costarc/MSXPi/hardware/Schematic/MSXPi_v0.7.0_Rev_1/msxpi.brd

## EAGLE design hardware/Schematic/MSXPi_v0.7.0_Rev_1/msxpi.brd (2017-06-21)

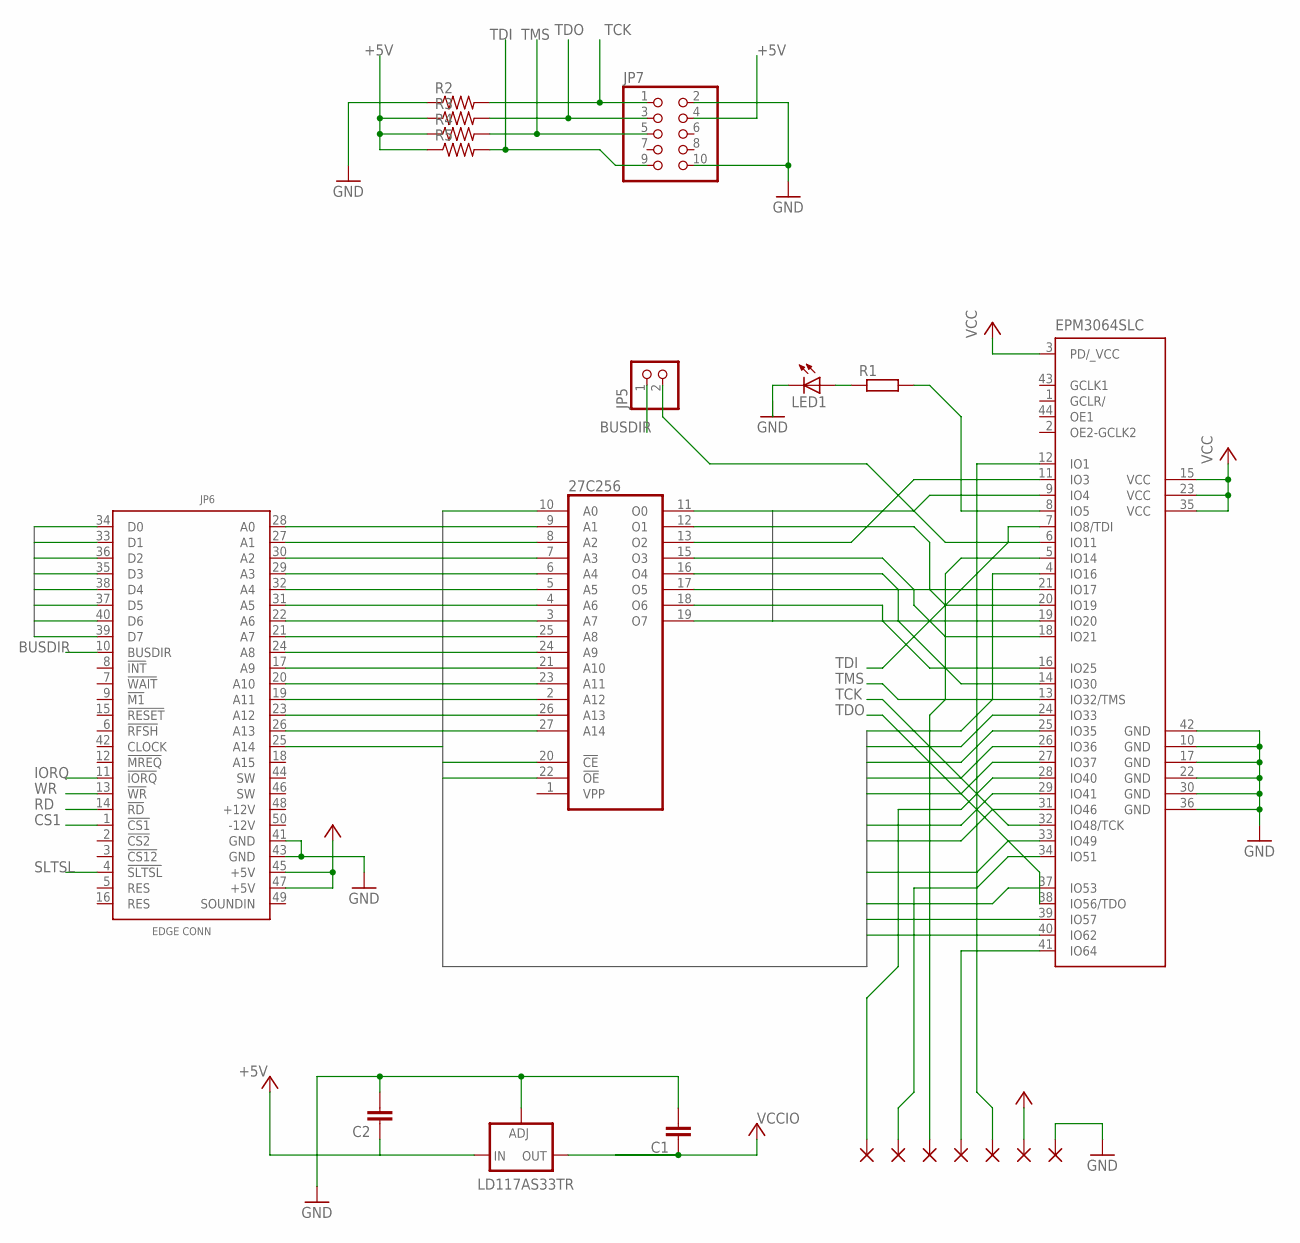
[picture p1: schematic msxpi.sch]

Parts:
27C256: 27256; DIL28
+5V: 2,15/1,0
C1, C2: C2,5-3; C2.5-3
EPM3064SLC: EPM3064S44; PLCC-S44
GND: 2,15/1,0
IC1: LD117AS33TR; SOT223
JP5: PINHD-1X2; 1X02
JP6: MSXCART1; MSXCART
JP7: PINHD-2X5/90; 2X05/90
LED1: LED3MM
PAD1, PAD2, PAD8, PAD9: 2,15/1,0
R1: R-EU_0207/7; 0207/7
R2, R3, R4, R5: R-US_0207/7; 0207/7
SPI_CS_GPIO21: 2,15/1,0

Connections:
+5V: 27C256.28 (VCC), +5V.1, C2.1, IC1.3 (IN), JP6.45 (+5V), JP6.47 (+5V), JP7.4, R3.1, R4.1, R5.1
A0: 27C256.10 (A0), EPM3064SLC.31 (IO46), JP6.28 (A0)
A1: 27C256.9 (A1), EPM3064SLC.29 (IO41), JP6.27 (A1)
A2: 27C256.8 (A2), EPM3064SLC.24 (IO33), JP6.30 (A2)
A3: 27C256.7 (A3), EPM3064SLC.26 (IO36), JP6.29 (A3)
A4: 27C256.6 (A4), EPM3064SLC.25 (IO35), JP6.32 (A4)
A5: 27C256.5 (A5), EPM3064SLC.27 (IO37), JP6.31 (A5)
A6: 27C256.4 (A6), EPM3064SLC.33 (IO49), JP6.22 (A6)
A7: 27C256.3 (A7), EPM3064SLC.4 (IO16), JP6.21 (A7)
A8: 27C256.25 (A8), JP6.24 (A8)
A9: 27C256.24 (A9), JP6.17 (A9)
A10: 27C256.21 (A10), JP6.20 (A10)
A11: 27C256.23 (A11), JP6.19 (A11)
A12: 27C256.2 (A12), JP6.23 (A12)
A13: 27C256.26 (A13), JP6.26 (A13)
A14: 27C256.27 (A14), JP6.25 (A14)
BUSDIR: JP5.1, JP6.10 (BUSDIR)
CS1: 27C256.22 (!OE), JP6.1 (!CS1)
D0: 27C256.11 (O0), EPM3064SLC.9 (IO4), JP6.34 (D0)
D1: 27C256.12 (O1), EPM3064SLC.20 (IO19), JP6.33 (D1)
D2: 27C256.13 (O2), EPM3064SLC.11 (IO3), JP6.36 (D2)
D3: 27C256.15 (O3), EPM3064SLC.18 (IO21), JP6.35 (D3)
D4: 27C256.16 (O4), EPM3064SLC.14 (IO30), JP6.38 (D4)
D5: 27C256.17 (O5), EPM3064SLC.21 (IO17), JP6.37 (D5)
D6: 27C256.18 (O6), EPM3064SLC.16 (IO25), JP6.40 (D6)
D7: 27C256.19 (O7), EPM3064SLC.19 (IO20), JP6.39 (D7)
GND: 27C256.14 (GND), C1.2, C2.2, EPM3064SLC.10 (GND), EPM3064SLC.17 (GND), EPM3064SLC.22 (GND), EPM3064SLC.30 (GND), EPM3064SLC.36 (GND), EPM3064SLC.42 (GND), GND.1, IC1.1 (ADJ), JP6.41 (GND), JP6.43 (GND), JP7.2, JP7.10, LED1.K (C), R2.1
IORQ: EPM3064SLC.40 (IO62), JP6.11 (!IORQ)
MSXR1: EPM3064SLC.6 (IO11), JP5.2
unnamed: LED1.A, R1.1
unnamed: EPM3064SLC.8 (IO5), R1.2
PI_RDY_GPIO25: EPM3064SLC.12 (IO1), PAD2.1
RD: EPM3064SLC.37 (IO53), JP6.14 (!RD)
SLTSL: 27C256.20 (!CE), JP6.4 (!SLTSL)
SPI_CS_GPIO21: EPM3064SLC.28 (IO40), SPI_CS_GPIO21.1
SPI_MISO_GPIO12: EPM3064SLC.41 (IO64), PAD1.1
SPI_MOSI_GPIO16: EPM3064SLC.5 (IO14), PAD9.1
SPI_SCLK_GPIO20: EPM3064SLC.34 (IO51), PAD8.1
TCK: EPM3064SLC.32 (IO48/TCK), JP7.1, R2.2
TDI: EPM3064SLC.7 (IO8/TDI), JP7.9, R5.2
TDO: EPM3064SLC.38 (IO56/TDO), JP7.3, R3.2
TMS: EPM3064SLC.13 (IO32/TMS), JP7.5, R4.2
VCCIO: C1.1, EPM3064SLC.3 (PD/_VCC), EPM3064SLC.15 (VCC), EPM3064SLC.23 (VCC), EPM3064SLC.35 (VCC), IC1.4 (OUT)
WR: EPM3064SLC.39 (IO57), JP6.13 (!WR)

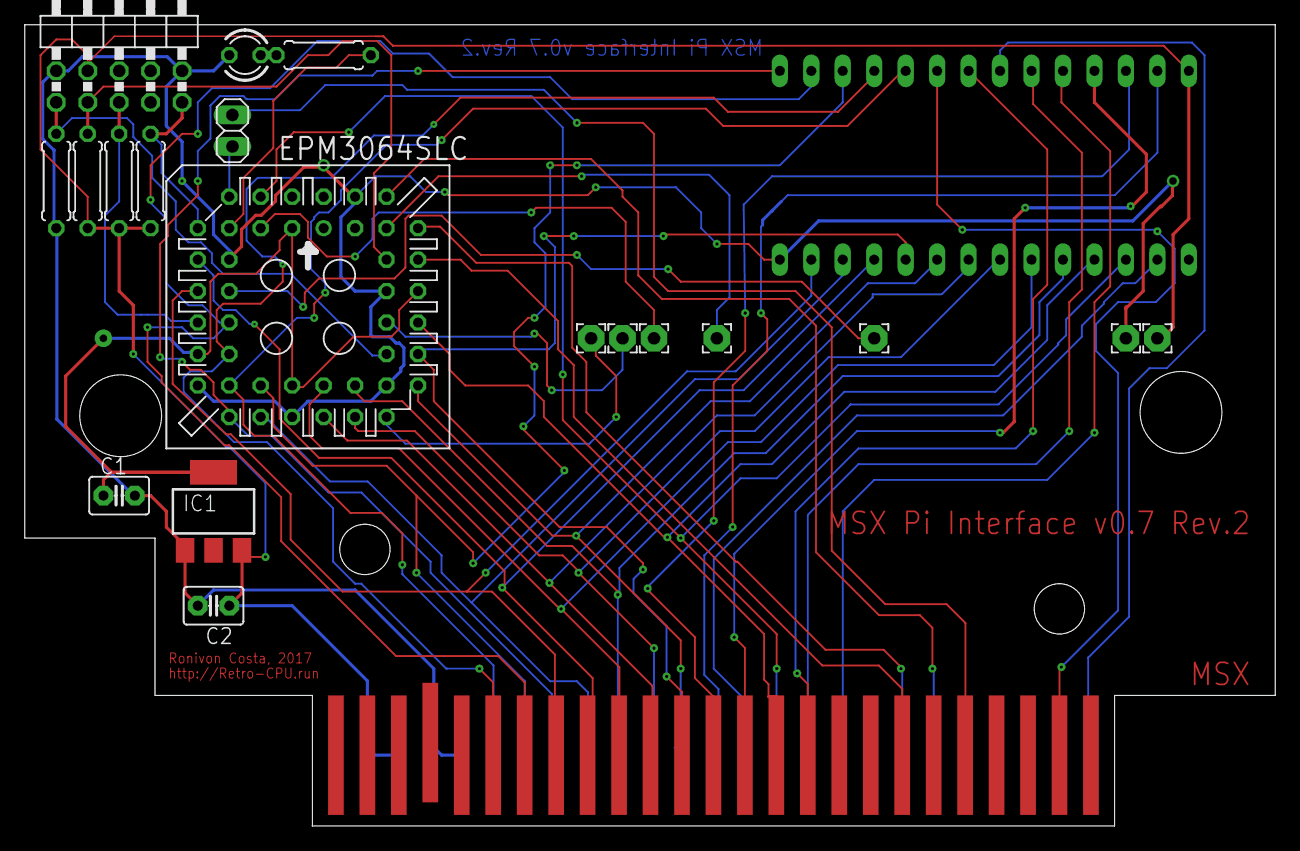
[picture p2: board msxpi.brd from above]

Board: 2 copper layers, 101.0 x 64.7 mm, 21 parts (1 on the bottom side), 44 nets.
