costarc/MSXPi/hardware/Schematic/MSXPi_v1.0_Rev1/MSXPi1.kicad_pcb

## KiCad design hardware/Schematic/MSXPi_v1.0_Rev1/MSXPi1.kicad_pcb (2020-08-07)

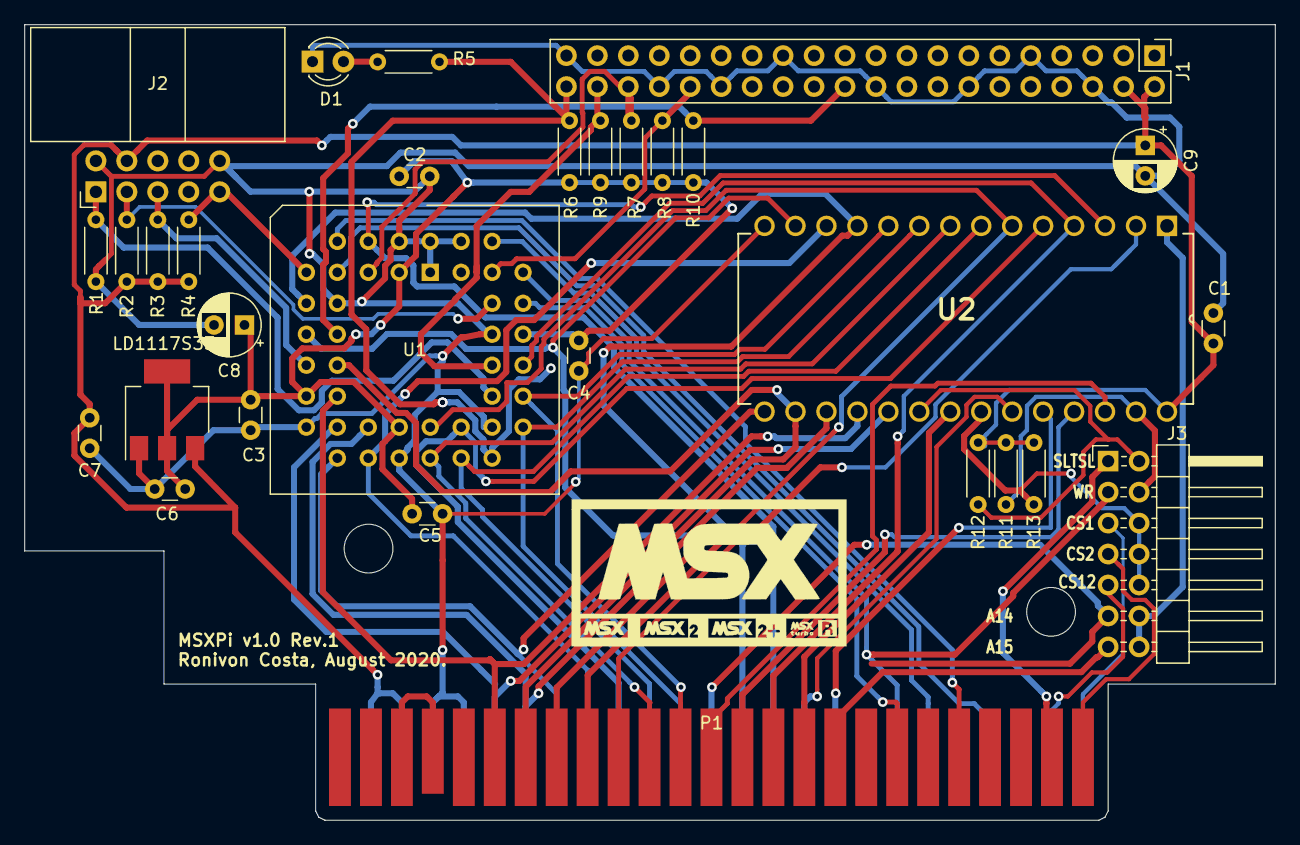
[picture p3: board MSXPi1.kicad_pcb from above]

Board: 2 copper layers, 102.6 x 65.3 mm, 30 parts (0 on the bottom side), 51 nets.

Parts:
C1, C2, C3, C4, C5, C6, C7: 100nF; C_Disc_D3.0mm_W1.6mm_P2.50mm
C8, C9: 100uF; CP_Radial_D5.0mm_P2.50mm
D1: LED; LED_D3.0mm
J1: Raspberry_Pi_Zero_2_3; PinHeader_2x20_P2.54mm_Vertical
J2: JTAG; IDC-Header_2x05_P2.54mm_Horizontal
J3: Conn_02x07_Odd_Even; PinHeader_2x07_P2.54mm_Horizontal
LD1117S33: LD1117S33TR_SOT223; SOT-223-3_TabPin2
P1: MSX_CONNECTOR; card_edge_connector
R1, R2, R3, R4: 1k; R_Axial_DIN0204_L3.6mm_D1.6mm_P5.08mm_Horizontal
R5: 270R; R_Axial_DIN0204_L3.6mm_D1.6mm_P5.08mm_Horizontal
R6, R7: 10K; R_Axial_DIN0204_L3.6mm_D1.6mm_P5.08mm_Horizontal
R8, R9, R10, R11, R12, R13: 10k; R_Axial_DIN0204_L3.6mm_D1.6mm_P5.08mm_Horizontal
U1: EPM3064ALC44-10; PLCC-44_THT-Socket
U2: AT28C256-15PU; DIP254P1524X482-28

Connections:
+3V3: C2.2, C3.2, C4.2, C5.2, C6.2, C8.1, LD1117S33.2, R6.2, R7.2, R8.2, R9.2, R10.2, U1.3, U1.15, U1.23, U1.35
+5V: C1.1, C7.2, C9.1, J1.2, J1.4, J2.4, LD1117S33.3, P1.45, P1.47, R2.2, R3.2, R4.2, R11.2, R12.2, R13.2, U2.28
A0: P1.28, U1.31, U2.10
A1: P1.27, U1.29, U2.9
A2: P1.30, U1.24, U2.8
A3: P1.29, U1.26, U2.7
A4: P1.32, U1.25, U2.6
A5: P1.31, U1.27, U2.5
A6: P1.22, U1.33, U2.4
A7: P1.21, U1.4, U2.3
A8: P1.24, U2.25
A9: P1.17, U2.24
A10: P1.20, U2.21
A11: P1.19, U2.23
A12: P1.23, U2.2
A13: P1.26, U2.26
A14: J3.11, P1.25
A15: J3.13, P1.18
BUSDIR: P1.10, U1.6
CS1: J3.5, P1.1
CS2: J3.7, P1.2
CS12: J3.9, P1.3
D0: P1.34, U1.9, U2.11
D1: P1.33, U1.20, U2.12
D2: P1.36, U1.11, U2.13
D3: P1.35, U1.18, U2.15
D4: P1.38, U1.14, U2.16
D5: P1.37, U1.21, U2.17
D6: P1.40, U1.16, U2.18
D7: P1.39, U1.19, U2.19
GNDREF: C1.2, C2.1, C3.1, C4.1, C5.1, C6.1, C7.1, C8.2, C9.2, D1.1, J1.6, J1.9, J1.14, J1.20, J1.25, J1.30, J1.34, J1.39, J2.2, J2.10, LD1117S33.1, P1.41, P1.43, R1.1, U1.1, U1.2, U1.10, U1.17, U1.22, U1.30, U1.36, U1.42, U1.44, U2.14
IORQ: P1.11, U1.40
unnamed: D1.2, R5.1
unnamed: P1.44, P1.46
RD: P1.14, U1.37
ROM_A14: J3.12, J3.14, U2.1
SLTSL: J3.1, P1.4
SPI_CS: J1.40, R5.2, R6.1, U1.28
SPI_MISO: J1.32, R8.1, U1.41
SPI_MOSI: J1.36, R7.1, U1.5
SPI_RDY: J1.22, R10.1, U1.12
SPI_SCLK: J1.38, R9.1, U1.34
TCK: J2.1, R1.2, U1.32
TDI: J2.9, R4.1, U1.7
TDO: J2.3, R2.1, U1.38
TMS: J2.5, R3.1, U1.13
WAIT: P1.7, U1.8
WR: J3.3, P1.13, U1.39
mem_ce: J3.2, R12.1, U2.20
mem_oe: J3.6, J3.8, J3.10, R13.1, U2.22
mem_we: J3.4, R11.1, U2.27
